berghem-in-the-middle/hardware-badge-no-hat-2023/STM32L010R8T6/Layout_L0.png

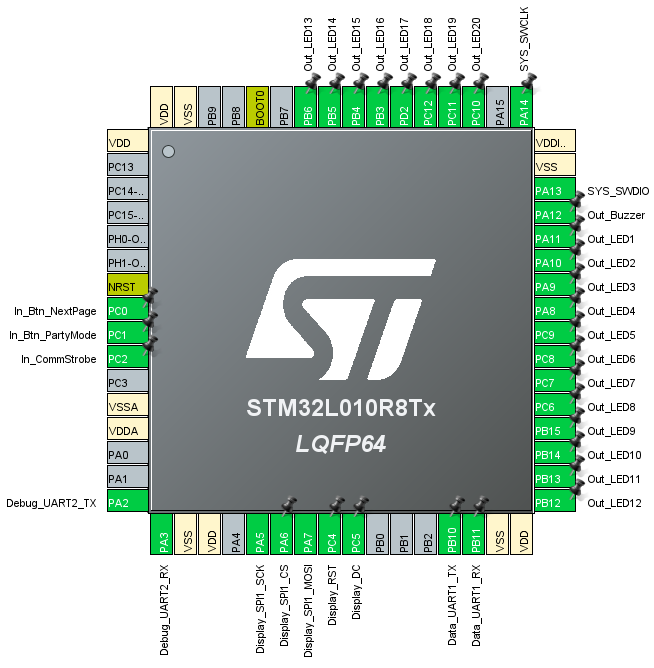
STM32L010R8T6/Layout_L0.png
