berghem-in-the-middle/hardware-badge-no-hat-2023/Hardware/SCHEMATIC1_PAGE1.pdf

## LOW CURRENT LED : < 5 mA. MANDATORY

## NOT MORE THAN 5 LED SWITCHED ON AT

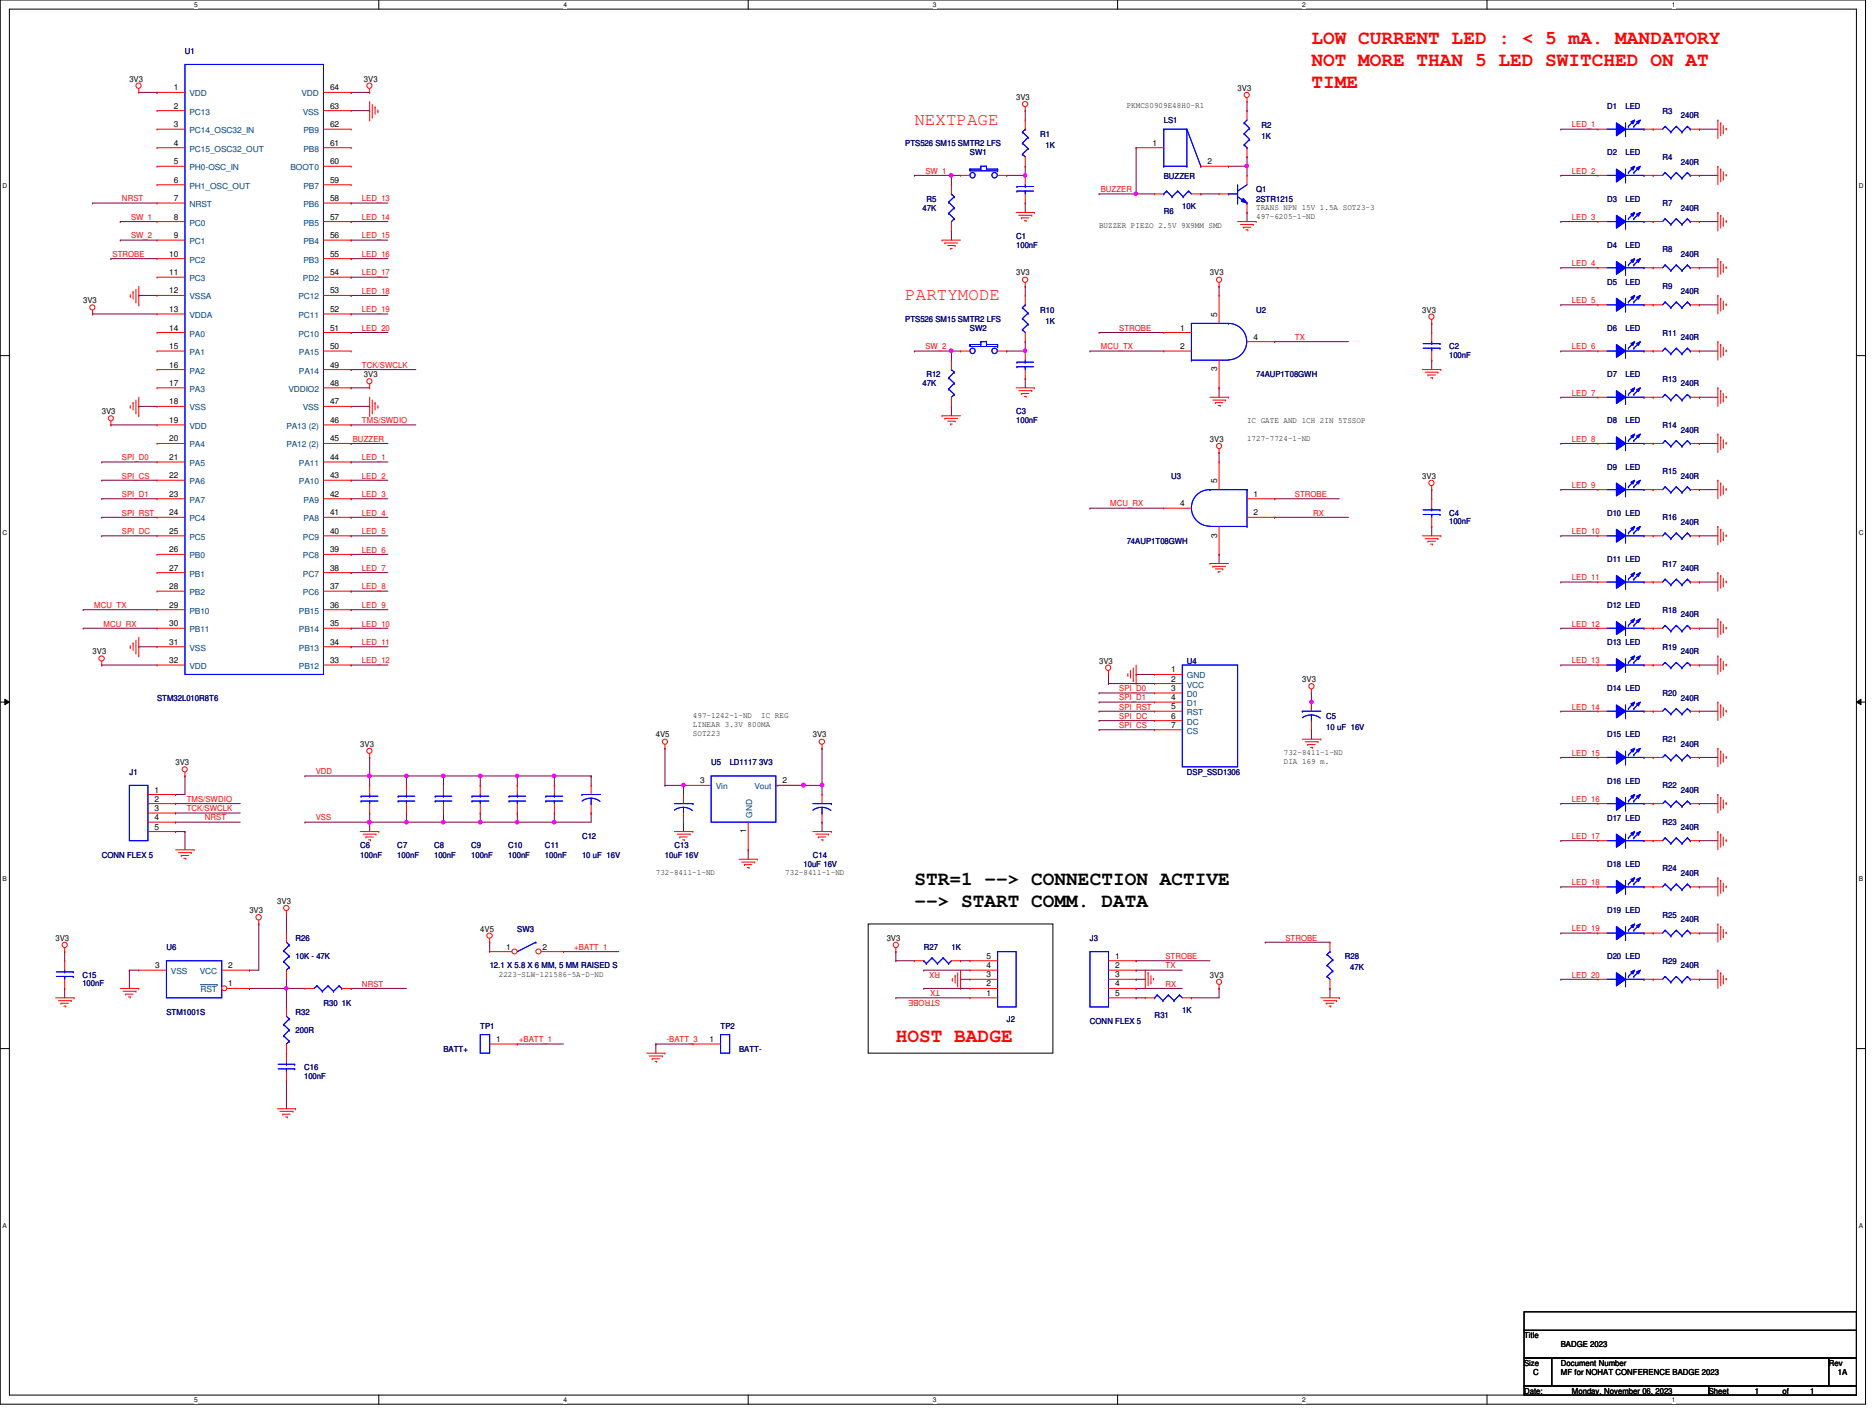
[picture p5: page 1]
