berghem-in-the-middle/hardware-badge-no-hat-2023/Hardware/Silkscreen Top.pdf

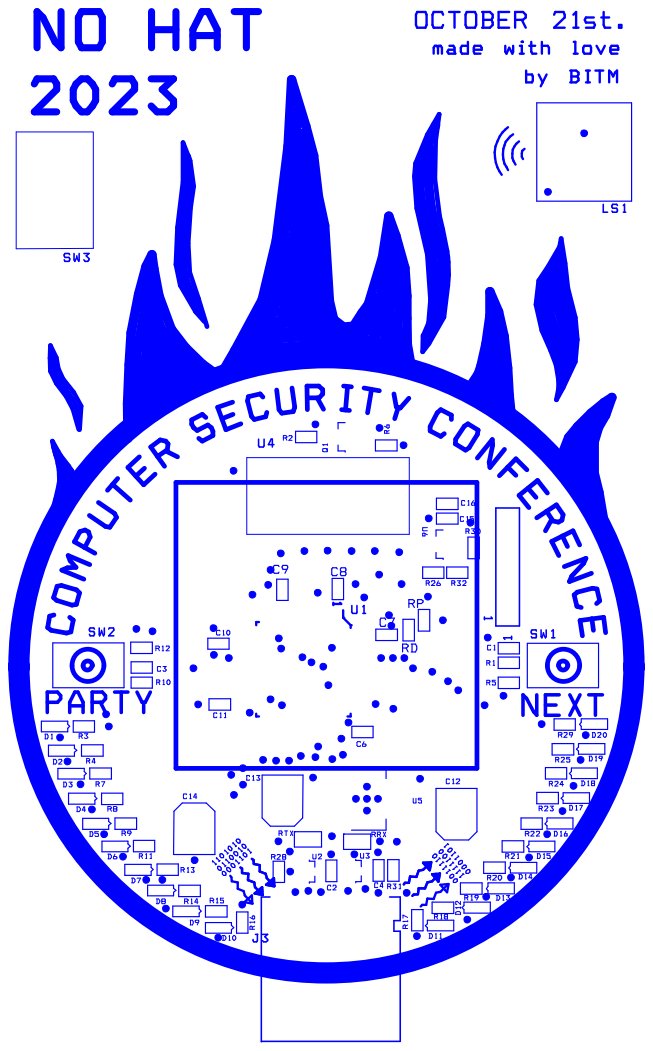
[picture p6: page 1]
