berghem-in-the-middle/hardware-badge-no-hat-2023/(list of files, drawings)

Other design files:
Hardware/schematic_capture_16.2/BADGE_PARK-3.DSN
Hardware/schematic_capture_16.2/BADGE_PARK-3.OPJ
