berghem-in-the-middle/hardware-badge-no-hat-2023/STM32L010R8T6/Core/Src/main.c

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
/* Includes ------------------------------------------------------------------*/
#include "main.h"

/* USER CODE BEGIN Includes */
#include "Display.h"
#include "Comm.h"
#include "Io.h"
#include "Appl.h"
#include <stdlib.h>
#include "eeprom.h"

/* USER CODE END Includes */

LPTIM_HandleTypeDef hlptim1;

UART_HandleTypeDef hlpuart1;
UART_HandleTypeDef huart2;

SPI_HandleTypeDef hspi1;

void SystemClock_Config(void);
static void MX_GPIO_Init(void);
static void MX_LPUART1_UART_Init(void);
static void MX_SPI1_Init(void);
static void MX_USART2_UART_Init(void);
static void MX_LPTIM1_Init(void);
/* USER CODE BEGIN 0 */
int _write(int file, char *ptr, int len)
{
#ifdef DEBUG
  HAL_UART_Transmit(&huart2, (uint8_t*)ptr, len, HAL_MAX_DELAY);
#endif
  return 0;
}
/* USER CODE END 0 */

/**
  * @brief  The application entry point.
  * @retval int
  */
int main(void)
{
  /* MCU Configuration--------------------------------------------------------*/

  /* Reset of all peripherals, Initializes the Flash interface and the Systick. */
  HAL_Init();

  /* Configure the system clock */
  SystemClock_Config();

  /* Initialize all configured peripherals */
  MX_GPIO_Init();
  MX_LPUART1_UART_Init();
  MX_SPI1_Init();
  MX_USART2_UART_Init();
  MX_LPTIM1_Init();
  /* USER CODE BEGIN 2 */
  HAL_FLASH_Unlock();
#ifdef DEBUG
  EE_Format();
#endif
  HAL_LPTIM_TimeOut_Start_IT(&hlptim1,1,IO_TIMER_TIMEOUT);
  EE_Init();
  Io_Init();
  Comm_Init();
  Appl_Init();
  /* USER CODE END 2 */

  /* Infinite loop */
  /* USER CODE BEGIN WHILE */
  while (1)
  {
    /* Run Display Manager */
    Appl_Mng();
    /* Run Communication Manager (blocking for ~15 ms) */
    Comm_Mng();
    /* Wait max 5 ms */
	  HAL_Delay(rand() % 5);
    /* USER CODE END WHILE */

    /* USER CODE BEGIN 3 */
  }
  /* USER CODE END 3 */
}

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
