berghem-in-the-middle/hardware-badge-no-hat-2023/STM32L010R8T6/Core/Src/Appl.h

/*
 * Appl.h
 *
 *  Created on: Aug 14, 2023
 *      Author: Nicola Vaccaro
 *      LinkedIn: https://www.linkedin.com/in/nicola-vaccaro/
 */

#ifndef SRC_APPL_H_
#define SRC_APPL_H_

/******************     Includes           *****************/

/******************     Public Define      *****************/

/******************     Public API         *****************/
void Appl_Init(void);
void Appl_Mng(void);

#endif /* SRC_APPL_H_ */
