berghem-in-the-middle/hardware-badge-no-hat-2023/(notices)

Notices in the files:
STM32L010R8T6/Core/Inc/main.h:
Copyright (c) 2023 STMicroelectronics.
All rights reserved.
This software is licensed under terms that can be found in the LICENSE file
